rsteiling/FlatPanelDriver/electrical/FlatPanelDriver_sch.pdf

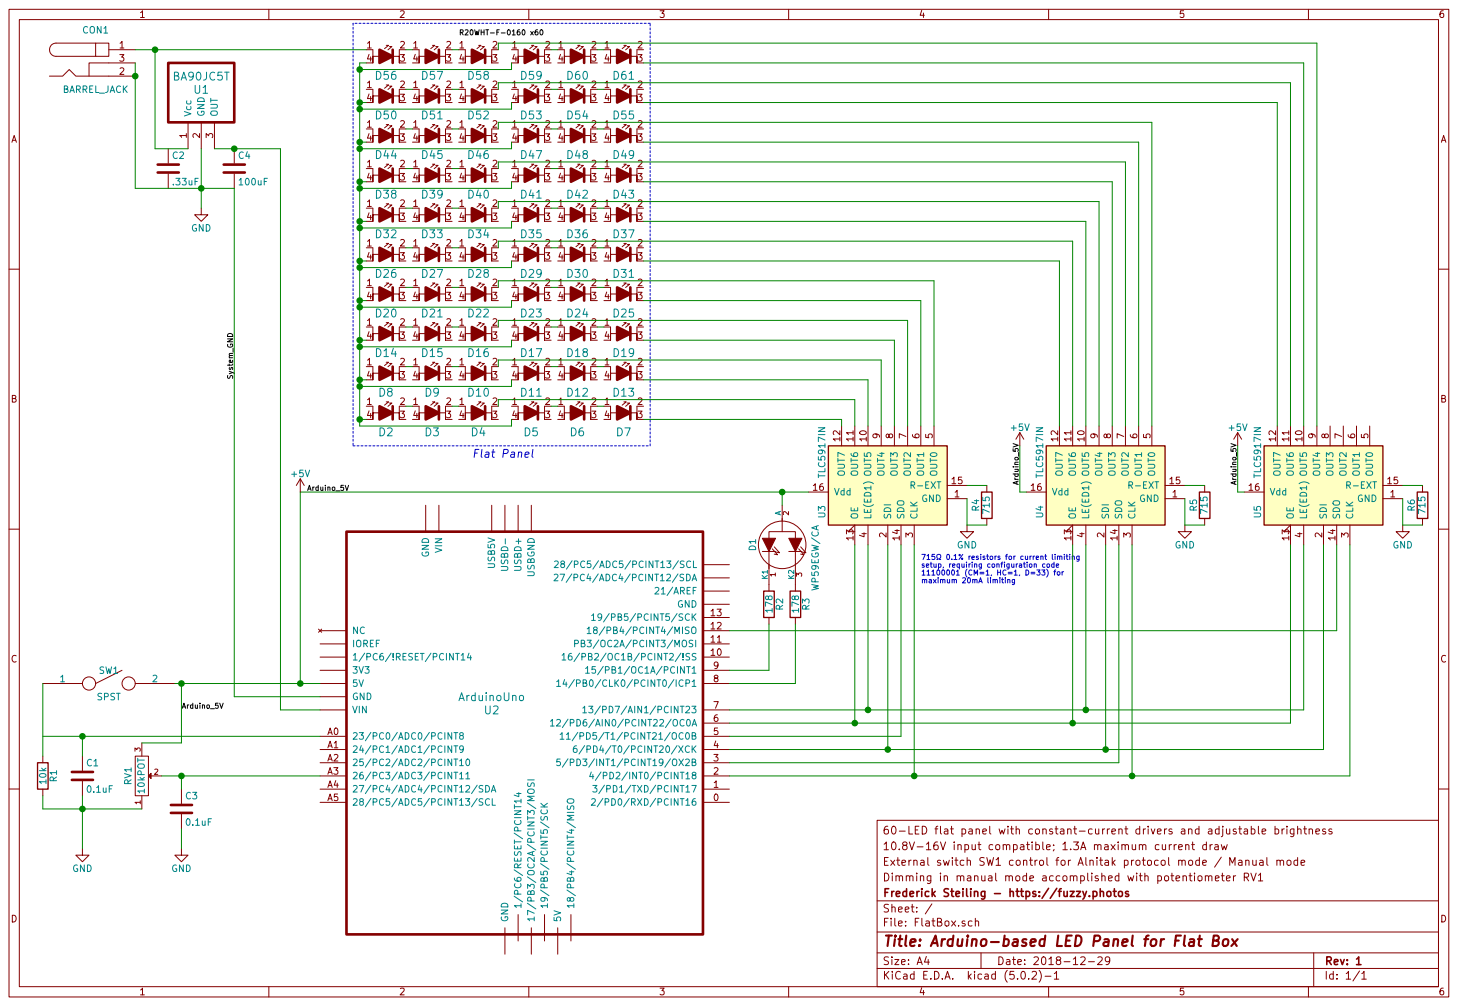
[picture p1: page 1]

9 OUT5 10 OUT6 11 OUT7 12 OE 13 SDO 14 R-EXT 15 Vdd 16 U3 TLC5917IN GND 178 R2 178 R3 R4 715

9 OUT5 10 OUT6 11 OUT7 12 OE 13 SDO 14 R-EXT 15 Vdd 16 U4 TLC5917IN R5 715 GND

9 OUT5 10 OUT6 11 OUT7 12 OE 13 SDO 14 R-EXT 15 Vdd 16 U5 TLC5917IN+5VArduino_5V R6 715 GND

715 0.1% resistors for current limiting
setup, requiring configuration code

60-LED flat panel with constant-current drivers and adjustable brightness
10.8V-16V input compatible; 1.3A maximum current draw
External switch SW1 control for Alnitak protocol mode / Manual mode
Dimming in manual mode accomplished with potentiometer RV1
File: FlatBox.sch Sheet: / Frederick Steiling - https://fuzzy.photos

Id: 1/1 Title: Arduino-based LED Panel for Flat Box
