rsteiling/FlatPanelDriver/flat_arduino/flat_arduino.ino

/*!
 * @file        flat_arduino.ino
 *
 * @brief       Ardruino Uno-based controller for LED panel panel drive.
 *
 * This implementation provides the basic controller interface for an
 * astrophotography-based flat panel driver utilizing TI TLC5917IN 8-channel 
 * constant current drivers.
 *
 * @author      Frederick Steiling
 *
 * @license     This project is released under GPLv3.
 */

#include <TimerOne.h>

/*!
 * Proproc define to enable serial debugging.
 * Set to (1) for serial debugging output at 9600 baud.  Doing so will insert 
 * serial output in the Alnitak data stream, so this will not work with any 
 * system expecting strict adherence to the protocol 
 */
#define DEBUG                 (0)

/* LED Driver pin definitions.  Modify as needed for the board hookup. */
#define SDI_FROM_LED_DRIVER   (3)
#define SDO_TO_LED_DRIVER     (5)
#define CLK_TO_LED_DRIVER     (2)
#define OE_LED_DRIVER_PWM     (6)
#define LE_LED_DRIVER         (7)

/* Status LED definitions. */
#define STATUS_RED            (9)
#define STATUS_GRN            (8)
#define STATUS_ON             (LOW)
#define STATUS_OFF            (HIGH)

/* Analog input definitions.  Modify as needed for the board hookup. */
#define SW_INPUT              (A0)
#define POT_INPUT             (A3)

/*!
 * Serial interrupt handler states.
 */
typedef enum {
    /* 8-bit (MSB first) transfer states. */
    SS_DataTransfer1,
    SS_DataTransfer2,
    SS_DataTransfer3,
    SS_DataTransfer4,
    SS_DataTransfer5,
    SS_DataTransfer6,
    SS_DataTransfer7,
    SS_DataTransfer8,
    /* Latching state, which occurs without any clocking. */
    SS_LatchEnable,
    /* Final wait state inserted to force a settle-out prior to subsequent 
     * transfers.  Lasts 1/2 clock period. */
    SS_Wait,
    NumSerialStates
} SerialState;

/*!
 * Transfer states for mode-switching.
 */
typedef enum {
    /* These are the main state transfers, each lasting a full clock cycle. */
    SMS_Transfer1,    /*  OE !LE  */
    SMS_Transfer2,    /* !OE !LE  */
    SMS_Transfer3,    /*  OE !LE  */
    SMS_Transfer4,    /*  OE Mode */
    SMS_Transfer5,    /*  OE !LE  */
    /* This wait state is inserted to force a settle-out prior to any subsequent
     * transfer.  Lasts 1/2 clock period. */
    SMS_Wait,
    NumSerialModeStates
} SerialModeState;

/*!
 * Definitions and structure for automated (de)assertion of mode-switching.
 */
typedef enum {
    MSL_OutputEnable,
    MSL_LatchEnable,
    NumModeSwitchLines
} ModeSwitchLines;

unsigned char modeStates[NumSerialModeStates][NumModeSwitchLines] = {
    { HIGH, LOW },
    { LOW,  LOW },
    { HIGH, LOW },
    { HIGH, LOW }, /* Here, the LE status will be updated by the initiation 
                    * function */
    { HIGH, LOW }
};

/* Interrupt-context serial transfer variables. */
volatile unsigned char  _txData;
volatile unsigned char  _rxData;
volatile bool           _transferInProgress;
volatile bool           _serialComplete;
volatile bool           _performLatch;
volatile bool           _configLatch;
volatile unsigned int   _state;

/* Serial transfer interrupt period (us). */
#define SERIAL_PULSE_WIDTH    (30)
#define SERIAL_WAIT_PERIOD    (1)

/* Configuration mode handler */
void _configurationHandler(void)
{
    if (digitalRead(CLK_TO_LED_DRIVER)) {
        /* Clock is high, so bring it low in preparation for the next data 
         * set */
        digitalWrite(CLK_TO_LED_DRIVER, LOW);

        /* So long as we're not passed the last data, put forth the next 
         * piece */
        if (++_state < SMS_Wait) {
            digitalWrite(OE_LED_DRIVER_PWM, 
                    modeStates[_state][MSL_OutputEnable]);
            digitalWrite(LE_LED_DRIVER, modeStates[_state][MSL_LatchEnable]);
        }
        else {
            /* We're finished with clocking.  Make sure all lines are back to 
             * the expected states */
            digitalWrite(OE_LED_DRIVER_PWM, HIGH);
            digitalWrite(LE_LED_DRIVER, LOW);

            /* Set the timer width for the wait period */
            /* XXX: Not currently using this
            Timer1.stop();
            Timer1.setPeriod(SERIAL_WAIT_PERIOD);
            Timer1.restart();
            */
        }
    }
    else {
        if (_state < SMS_Wait) {
            /* The clock is low, so the data is already set and all we need to 
             * do is go high to clock it in: */
            digitalWrite(CLK_TO_LED_DRIVER, HIGH);
        }
        else {
            if (_state++ >= (NumSerialModeStates + SERIAL_WAIT_PERIOD)) {
                /* Stop the timer and set completion variables */
                Timer1.stop();
                _transferInProgress = false;
                _serialComplete = true;
            }
        }
    }
}

/*!
 * Change configuration modes.
 */
bool switchDriverModes(bool specialMode)
{
    bool retval = false;
    _serialComplete = false;

    /* Only permit a change in modes if we're not currently transferring */
    if (!_transferInProgress) {
        _transferInProgress = true;
    
        /* Changing modes renders the receive data invalid. */
        /* XXX: ...but we really should track the validity of it better... */
        _rxData = 0;

        /* Set the Timer1 handler */
        Timer1.attachInterrupt(&_configurationHandler);
    
        /* The clock should already be low, but go ahead and re-assert */
        digitalWrite(CLK_TO_LED_DRIVER, LOW);

        /* Simply hold the data-out line low */
        digitalWrite(SDO_TO_LED_DRIVER, LOW);

        /* Initialize the state */
        _state = SMS_Transfer1;

        /* Set the mode type */
        modeStates[SMS_Transfer4][MSL_LatchEnable] = specialMode ? HIGH : LOW;

        /* Set the initial line states */
        digitalWrite(OE_LED_DRIVER_PWM, modeStates[_state][MSL_OutputEnable]);
        digitalWrite(LE_LED_DRIVER, modeStates[_state][MSL_LatchEnable]);

        /* Start the transfer timer */
        Timer1.setPeriod(SERIAL_PULSE_WIDTH);
        Timer1.restart();

        /* Indicate to the caller that we've started successfully */
        retval = true;
    }
  
    return retval;
}

/*!
 * Serial interrupt handler.
 */
void _serialHandler(void)
{
    if (_state < SS_LatchEnable) {
        if (digitalRead(CLK_TO_LED_DRIVER)) {
            /* Clock is high; handle a falling edge */
            digitalWrite(CLK_TO_LED_DRIVER, LOW);

            /* Set the next bit unless it's time to latch */
            if (++_state < SS_LatchEnable) {
                /* Transfer in the next data */
                _txData <<= 1;
                digitalWrite(SDO_TO_LED_DRIVER, (_txData & 0x80) ? HIGH : LOW);

                /* If this is the last data bit *and* we are in a configuration 
                 * latch scenario, we also need to assert LE */
                if ((_state == SS_DataTransfer8) && _configLatch) {
                    digitalWrite(LE_LED_DRIVER, HIGH);
                }
            }
            else {
                if (_performLatch) {
                    /* If we're supposed to, latch the transferred data to 
                     * the driver register */
                    digitalWrite(LE_LED_DRIVER, HIGH);
                }
                else {
                    /* If we're not supposed to, go ahead and clear it, which 
                     * also handles the possible configuration latch scenario */
                    digitalWrite(LE_LED_DRIVER, LOW);
                }
            }
        }
        else {
            /* Shift in the rx data */
            _rxData <<= 1;
            _rxData |= (digitalRead(SDI_FROM_LED_DRIVER) ? 0x01 : 0x00);
      
            /* Clock is low; handle a rising edge */
            digitalWrite(CLK_TO_LED_DRIVER, HIGH);
        }
    }
    else {
        /* Disable the latch */
        digitalWrite(LE_LED_DRIVER, LOW);
    
        if (_state++ >= (NumSerialStates + SERIAL_WAIT_PERIOD)) {
            /* We're at the Latch state (even if we didn't need to latch), 
             * which means we're finished:
               - Stop the timer
               - (Re)Set all the indicator variables
               - De-assert the latch.  */
            Timer1.stop();
            _transferInProgress = false;
            _serialComplete = true;
        }
    }
}

/*!
 * Initiate a read or write of generic data to/from the serial interface.
 */
bool initiateSerialTransfer(unsigned char data, bool latchData, 
                            bool latchConfig)
{
    bool retval = false;
    _serialComplete = false;
  
    if (!_transferInProgress) {
        _transferInProgress = true;
        _txData = data;
        /*_rxData = 0;*/

        /* Set the handler */
        Timer1.attachInterrupt(&_serialHandler);
    
        /* The clock should already be low, but go ahead and re-assert */
        digitalWrite(CLK_TO_LED_DRIVER, LOW);

        /* Present the first data */
        digitalWrite(SDO_TO_LED_DRIVER, (_txData & 0x80) ? HIGH : LOW);

        /* Set the state */
        _state = SS_DataTransfer1;

        /* Indicate whether we should latch or not */
        _performLatch = latchData;
        _configLatch = latchConfig;

        /* Start our transfer timer */
        Timer1.setPeriod(SERIAL_PULSE_WIDTH);
        Timer1.restart();

        /* Indicate to the caller that we've started successfully */
        retval = true;
    }

    return retval;
}

void ConfigurePWM(void) {
    /* Make sure the PWM output is set high */
    digitalWrite(OE_LED_DRIVER_PWM, HIGH); 
    /* Default to 0% PWM (inverted mode) */
    OCR0A = 255;
    /* Prescale factor of 64; This should be the default already, and should not
     * affect calls to delay(), millis(), etc. */
    TCCR0B = _BV(CS00) | _BV(CS01);
    /* Set fast PWM mode, non-inverting mode: Timer 0A / pin 6 */
    TCCR0A = _BV(COM0A1) | _BV(WGM01) | _BV(WGM00);
    /* Lastly, set it as an output (unnecessary) */
    /*pinMode(OE_LED_DRIVER_PWM, OUTPUT);*/
}

void UnConfigurePWM(void) {
    /* Set the port for "normal port operation" (i.e. disconnected) */
    TCCR0A = 0;
    /* Make sure the output is set high */
    digitalWrite(OE_LED_DRIVER_PWM, HIGH);
    /* Make sure the pin is set as an output */
    pinMode(OE_LED_DRIVER_PWM, OUTPUT);
}

void setup() {
    /************************************/
    /* Set up TLC5917IN LED driver pins */
    /************************************/

    /* Set the data-in to an input */
    pinMode(SDI_FROM_LED_DRIVER, INPUT);

    /* Set data-out to the driver as an output, starting low */
    digitalWrite(SDO_TO_LED_DRIVER, LOW);
    pinMode(SDO_TO_LED_DRIVER, OUTPUT);

    /* Set CLK as output, and drive it low */
    digitalWrite(CLK_TO_LED_DRIVER, LOW);
    pinMode(CLK_TO_LED_DRIVER, OUTPUT);
    
    /* Disable the latch line */
    digitalWrite(LE_LED_DRIVER, LOW);
    pinMode(LE_LED_DRIVER, OUTPUT);

    /* Use the Atmega Fast PWM mode for the OE line to control dimming.  Start
    * with it disabled. */
    UnConfigurePWM();

    /***********************************/
    /* Serial bit-bang interrupt setup */
    /***********************************/

    /* 50us clock period / 25us pulses. Plenty long per the driver datasheet. */
    Timer1.initialize(SERIAL_PULSE_WIDTH);
    /* Make sure the thing is stopped */
    Timer1.stop();
    /* Set the handler */
    Timer1.attachInterrupt(&_serialHandler);

    /**********************************/
    /* Set up the analog switch input */
    /**********************************/
    /* Nothing to do */
    
    /*************************************/
    /* Configure the potentiometer input */
    /*************************************/
    /* Nothing to do */

    /*****************************/
    /* Configure the status LEDs */
    /*****************************/
    /* Red */
    digitalWrite(STATUS_RED, STATUS_ON);
    pinMode(STATUS_RED, OUTPUT);
    /* Green */
    digitalWrite(STATUS_GRN, STATUS_OFF);
    pinMode(STATUS_GRN, OUTPUT);

    /* Start the serial port at 9600 */
    Serial.begin(9600);

    /* Clear the serial stream */
    while (Serial.available() > 0) Serial.read();
}

/*!
 * Operational states.
 */
typedef enum {
    US_SetStandardModeInit,
    US_ClearLEDStates,
    US_SetConfigMode,
    US_SetCurrentGain,
    US_SetStandardMode,
    US_SetPWM,
    US_SetLEDStates,
    /*US_ReadLEDStates,*/
    US_Run,
    NumUserStates
} UserStates;

#ifdef DEBUG
/*!
 * String definitions for current states.
 */
const char *stateNames[NumUserStates] = {
    "SetStandardModeInit",
    "ClearLEDStates",
    "SetConfigMode",
    "SetCurrentGain",
    "SetStandardMode",
    "SetPWM",
    "SetLEDStates",
    "Run"
};

/*!
 * Print the current state to the serial port.
 */
void debugStatement(const char *msg, int state)
{
    /* First print the state name */
    Serial.print(stateNames[state]);

    /* Then a separator */
    Serial.print(": ");

    /* Then the message */
    Serial.println(msg);
}
#endif

/*!
 * Read the current state of the mode switch.
 */
bool readSwitch(void)
{
    /* XXX: Would be wise to build in some debounce... */
    return (analogRead(SW_INPUT) == 0) ? false : true;
}

/*!
 * Tracker for the LED brightness from 0-255.
 */
static unsigned char brightness = 0;

/*!
 * Status definition for the light driver state
 */
typedef enum {
    LightsOff = 0,
    LightsOn  = 1
} LightStatus;

/*!
 * Tracker for the light driver state
 */
static LightStatus lights = LightsOn;

/*!
 * Status definition for the cover states.  
 * This is unused in this implementation, but included for Alnitak protocol
 * completeness.
 */
typedef enum {
    CoverUnknown = 0,
    CoverClosed  = 1,
    CoverOpen    = 2
} CoverStatus;

/*!
 * Tracker for the cover status.
 */
static CoverStatus cover = CoverUnknown;

/*!
 * Status definition for the motor states.
 * This is unused in this implementation, but included for Alnitak protocol
 * completeness.
 */
typedef enum {
    MotorStopped = 0,
    MotorRunning = 1
} MotorStatus;

/*!
 * Tracker for the motor status.
 */
static MotorStatus motor = MotorStopped;

/*!
 * Helper function to set the PWM output (0-255)
 */
void SetPWMOutput(unsigned char range) {
    OCR0A = (255 - range);
}

/*!
 * Helper to set the LED brightness and save the state
 */
void SetBrightness(unsigned char newBrightness) {
    /* Update the brightness value */
    brightness = newBrightness;

    /* Only actually set the brightness if the lights are on */
    if (lights == LightsOn) SetPWMOutput(brightness);
}

/*!
 * Helper for get the current brightness level.
 */
unsigned char GetBrightness(void) {
    return brightness;
}

/*!
 * Helper to set the lighted status.
 */
void SetLights(unsigned char newLights) {
    /* Set the new status */
    lights = (LightStatus)newLights;

    /* Enable or disable the LEDs as appropriate */
    if (lights == LightsOff) {
        /* Disable by turning off the PWM */
        SetPWMOutput(0);
    }
    else { /* LightsOn */
        SetPWMOutput(brightness);
    }
}

/*!
 * Helper to get the current lighted status.
 */
unsigned char GetLights(void) {
    return lights;
}

/*!
 * Helper to set the current cover status.
 */
void SetCover(unsigned char newCover) {
    /* XXX: A cover is currently unimplementated in this design */
}

/*!
 * Helper to get the current cover status.
 */
unsigned char GetCover(void) {
    return cover;
}

/*!
 * Helper to get the current motor status.
 */
unsigned char GetMotor(void) {
    return motor;
}

/*!
 * Helper to process the Alnitak protocol
 */
void handleAlnitak(void) {
    /*********************/
    /* Alnitak Emulation */
    /*********************/

    /*
     * This code follows the "manual" flat box protocol and does not support 
     * flip commands, though proper responses are sent for all.
     *
     * The protocol is as follows:
     *
     * Ping         >P000CR   *Pii000CR     Used to find device
     * Open         >O000CR   *Oii000CR     Open cover (FF only - NOT SUPPORTED)
     * Close        >C000CR   *Cii000CR     Close cover(FF only - NOT SUPPORTED)
     * Light on     >L000CR   *Lii000CR     Turn on light
     * Light off    >D000CR   *Dii000CR     Turn off light
     * Brightness   >BxxxCR   *BiixxxCR     Set brightness (xxx = 000-255)
     * Brightness   >J000CR   *JiixxxCR     Get brightness from device
     * State        >S000CR   *SiiqrsCR     Get device status
     * Version      >V000CR   *ViivvvCR     Get firmware version  
     */

    /* Commands are all 6 characters (including the newline char) */
    if (Serial.available() >= 6) {
        enum {
            STREAM_LENGTH = 20,
            RESPONSE_LENGTH = 10
        };

        typedef enum
        {
            FLAT_MAN_L = 10,
            FLAT_MAN_XL = 15,
            FLAT_MAN = 19,
            FLIP_FLAT = 99
        } AlnitakFlatTypes;

        const int deviceType = FLAT_MAN;

        /* Indicate that we are performing Alnitak communication */
        digitalWrite(STATUS_RED, STATUS_ON);
      
        /* String for the incoming stream */
        char str[STREAM_LENGTH];
        memset(str, 0, STREAM_LENGTH);

        /* String for our response, which will only ever be 9 characters 
         * including the newline */
        char resp[RESPONSE_LENGTH];
        memset(resp, 0, RESPONSE_LENGTH);

        /* Read bytes up to the protocol frame delimeter */
        int read = Serial.readBytesUntil('\n', str, STREAM_LENGTH);

        /* First, make sure we actually have a valid command.  If we don't, 
         * it's possible we've gotten out of sync. */
        if ((read == 5) && (str[0] == '>')) {
            /* Create pointers to pertinant data: */
            char *cmd  = str + 1;
            char *data = str + 2;

            switch (*cmd) {
                case 'P':
                    /* Ping: *Pii000CR */
                    sprintf(resp, "*P%02d000\n", deviceType);
                    break;  
                case 'O':
                    /* Open shutter (NOT SUPPORTED) */
                    SetCover(CoverOpen);
                    sprintf(resp, "*O%02d000\n", deviceType);
                    break;
                case 'C':
                    /* Close shutter (NOT SUPPORTED) */
                    SetCover(CoverClosed);
                    sprintf(resp, "*C%02d000\n", deviceType);
                    break;
                case 'L':
                    /* Turn lights on.  Any previous dimming level needs to 
                     * be restored. */
                    SetLights(LightsOn);
                    sprintf(resp, "*L%02d000\n", deviceType);
                    break;
                case 'D':
                    /* Turn lights off.  The current dimming level needs to 
                     * be retained. */
                    SetLights(LightsOff);
                    sprintf(resp, "*D%02d000\n", deviceType);
                    break;
                case 'B':
                    /* Set brightness. */
                    SetBrightness(atoi(data));
                    sprintf(resp, "*B%02d%03d\n", deviceType, GetBrightness());
                    break;
                case 'J':
                    /* Get the brightness. */
                    sprintf(resp, "*J%02d%03d\n", deviceType, GetBrightness());
                    break;
                case 'S':
                    /* Get device status.  We have no motor and no shutter, 
                     * so really we're just reporting the light status: */
                    sprintf(resp, "*S%02d%d%d%d\n", deviceType, GetMotor(), 
                            GetLights(), GetCover());
                    break;
                case 'V':
                    /* Get the firmware version.  This is hard-coded at 1 for 
                     * now. FIXME: Don't make it always 1, though. */
                    sprintf(resp, "*V%02d%03d\n", deviceType, 1);
                    break;
                default:
                    /* Something's terribly wrong here (like perhaps a dropped 
                     * character?) */
                    break;
            }

            /* Send the response: */
            Serial.print(resp);
        }
      
        /* There's probably a wiser approach here (like allowing multiple 
         * commands before we're able to respond), but for now we'll just 
         * clear the port: */
        while (Serial.available() > 0) Serial.read();
      
        /* Turn off the LED to indicate communication is done. */
        digitalWrite(STATUS_RED, STATUS_OFF);
    }
}

/*!
 * Runs the program by checking for a switch of modes and calling the 
 * appropriate handler.
 */
void runUserState(void) {
    typedef enum {
        ManualMode,
        AlnitakEmulation,
    } OperationModes;

    /* User mode variable */
    static int mode = ManualMode;
  
    /* Variable to track switch state changes */
    static bool lastSwitchState = false;

    /* Look for a mode switch: */
    bool switchState = readSwitch();
    if (switchState != lastSwitchState) {
        lastSwitchState = switchState;

        unsigned char red, grn;

        /* Switch ON = Alnitak Emulation */
        if (switchState) {
            mode = AlnitakEmulation;
            grn = STATUS_ON;
            red = STATUS_OFF;

            /* When we get into emulation mode, make sure the PWM output is 
             * set to what it was during the last emulation mode: */
            SetBrightness(brightness);
            SetLights(lights);
        }
        /* Switch OFF = Manual Mode */
        else {
            mode = ManualMode;
            grn = STATUS_OFF;
            red = STATUS_ON;
        }

        /* Set the status LED */
        digitalWrite(STATUS_RED, red);
        digitalWrite(STATUS_GRN, grn);
    }
         
    if (mode == ManualMode) {
        /* If the switch is on, we'll use the pot to adjust the level 
         * brightness */
        int pot = analogRead(POT_INPUT);
        int level = pot >> 2;
        SetPWMOutput(analogRead(POT_INPUT) >> 2);
    }
    else {     
        /* Otherwise, call the Alnitak handleer */
        handleAlnitak();
    }
}

/*!
 * Main Arduino program loop.
 */
void loop(void) {
    /* Declare a variable to track our application state: */
    static int userState = US_SetStandardModeInit;
  
    switch (userState) {
        case US_SetStandardModeInit:
        {
            /* With the current gain configuration complete, we want to go 
             * back to standard mode */
            if (switchDriverModes(false)) {
#if DEBUG
                debugStatement("Finished", userState);
#endif
                userState++;
            }
        }
        break;
    
        case US_ClearLEDStates:
        {
            /* Initiate a standard transfer to clear the LED state */
            if (initiateSerialTransfer(0x00, true, false)) {          
#if DEBUG
                debugStatement("Finished", userState);
#endif
                userState++;
            }
        }
        break;
    
        case US_SetConfigMode:
        {
            /* Here, we simply want to get the part into configuration mode so 
             * that we can set the current gain. */
            if (switchDriverModes(true)) {     
#if DEBUG
                debugStatement("Finished", userState);
#endif
                ++userState;
            }
        }
        break;

        case US_SetCurrentGain:
        {
            /* With a 715 ohm resistor in place, desiring 20mA per output, and 
             * taking into consideration all worst-case part tolerances, it 
             * has been determined that a value of CM=1/HC=1/D=33 should be 
             * used for nominal current limiting.  The datasheet does very 
             * strange things and lists their values starting at bit 0... 
             * backward from standard convention.  This is probably because 
             * the part expects the most significant bit first.  Regardless, 
             * with the calculated value in mind and knowing our driver 
             * transmits MSB first, our desired value is 0b10000111.  (However, 
             * note if lining up with pg 23 of the datasheet that this value is 
             * written instead as 0b11100001.  This is about as confusing as 
             * it gets.  Thanks TI!) */
            if (initiateSerialTransfer(0x87, false, true)) {
#if DEBUG
                debugStatement("Finished", userState);
#endif
                ++userState;
            }
        }
        break;

        case US_SetStandardMode:
        {
            /* With the current gain configuration complete, we want to go 
             * back to standard mode */
            if (switchDriverModes(false)) {
#if DEBUG
                debugStatement("Finished", userState);
#endif
                ++userState;
            }
        }
        break;

        case US_SetPWM:
        {
            if (!_transferInProgress) {
                ConfigurePWM();
#if DEBUG
                debugStatement("Finished", userState);
#endif
                /* A small settle-out delay.  There has been evidence that this 
                 * output needs time to chill out before we enable the LEDs. */
                delay(25);
                ++userState;
            }
        }
        break;

        case US_SetLEDStates:
        {
            /* Initiate a standard transfer to set the LED state */
            if (initiateSerialTransfer(0x3f, true, false)) {
#if DEBUG
                debugStatement("Finished", userState);
#endif
            ++userState;
            }
        }
        break;
      
        case US_Run:
        default:
        {
            runUserState();
            break;
        }
    }
}
